lhr-solar/BPS-DisplayPCB/bps_display.FCStd

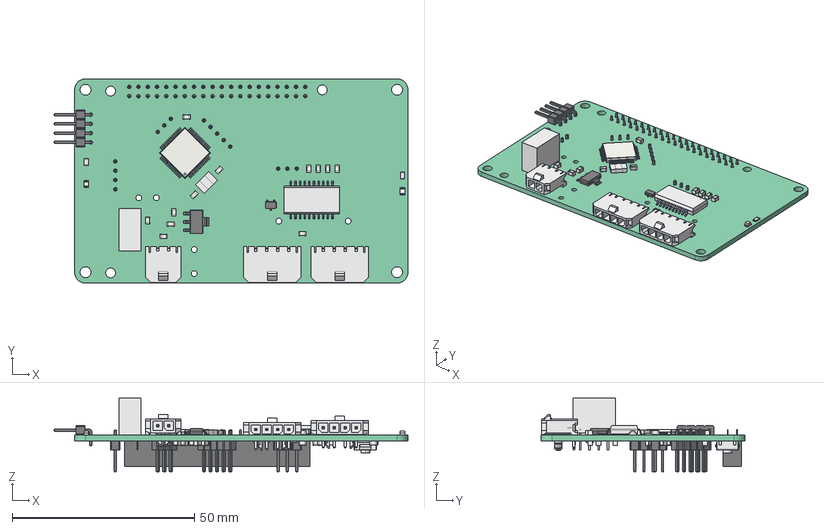
[picture p1: CAD file, 2023-05-16]
bps_display.FCStd
97.0 x 56.0 x 20.2 mm
Pcb_20f8
U2_RI_20_1_ADI_5F66359D[2]
U3_SOT_23W_5F8B4F3E
J2_436500400_5FDCC974[2]
R4_R_0805_2012Metric_5FDE32D0
D2_LED_0805_2012Metric_5FDCB850
J3_436500400_5F821408[2]
U7_SOT_223_5F8224BE
R7_R_0805_2012Metric_5F5D4CE2
D1_LED_0805_2012Metric_5F5D4B01
C25_C_0805_2012Metric_5F5D4AEE
C24_C_0805_2012Metric_5FDE2ECA
C23_C_0805_2012Metric_5FDE28B4
C22_C_0805_2012Metric_5F664578
C19_C_0805_2012Metric_5F5D4AAA
C18_C_0805_2012Metric_5F8B46F2
C17_C_0805_2012Metric_5F5D4A88
C16_C_0805_2012Metric_5FDE1973
C14_C_0805_2012Metric_5FDE4908
Y1_CRYSTAL_TXC_7A_TXC_5F5D3D47[2]
U1_LQFP_64_10x10mm_P05mm_5FDE7541
J1_PinHeader_1x04_P254mm_Horizontal_5F5D6779
C11_C_0805_2012Metric_5F5D3C04
C10_C_0805_2012Metric_5F5D3BF3
C9_C_0805_2012Metric_5F5D6A39
J5_436500200_5F8B5146[2]
U6_CUI_PDS1-S12-S5-S_5FDE26E9
R2_R_0805_2012Metric_5F8B4C7D
J6_PinHeader_1x03_P254mm_Vertical_5F8B5AE3
P1_PinSocket_2x20_P254mm_Vertical_5F8B462C
J9_PinHeader_1x03_P254mm_Vertical_5F8B6365
J8_PinHeader_1x04_P254mm_Vertical_5FDE31D0
J7_PinHeader_1x05_P254mm_Vertical_5F8B6C4F
R3_R_0805_2012Metric_5F8B4C1D
R1_R_0805_2012Metric_5F66A47C
L2_L_0805_2012Metric_5F8B4C4D
L1_L_0805_2012Metric_5F8B4CF5
C15_C_0805_2012Metric_5FDE48B7
C13_C_0805_2012Metric_5F8B4BED
C12_C_0805_2012Metric_5F8B4B5D
SW1_B3SL_100[]P_5F5D3CCB[2]
C8_C_0805_2012Metric_5F5D3BD1
C7_C_0805_2012Metric_5F8B425E
C6_C_0805_2012Metric_5F5D3BAF
C5_C_0805_2012Metric_5FDE7AA1
C4_C_0805_2012Metric_5F5D3B8D
C3_C_0805_2012Metric_5F5D3B7C
C2_C_0805_2012Metric_5F8BED01
C1_C_0805_2012Metric_5F5D3B5A
