lhr-solar/BPS-DisplayPCB/BPSDisplay.kicad_pcb

## KiCad design BPSDisplay.kicad_pcb (2023-05-16)

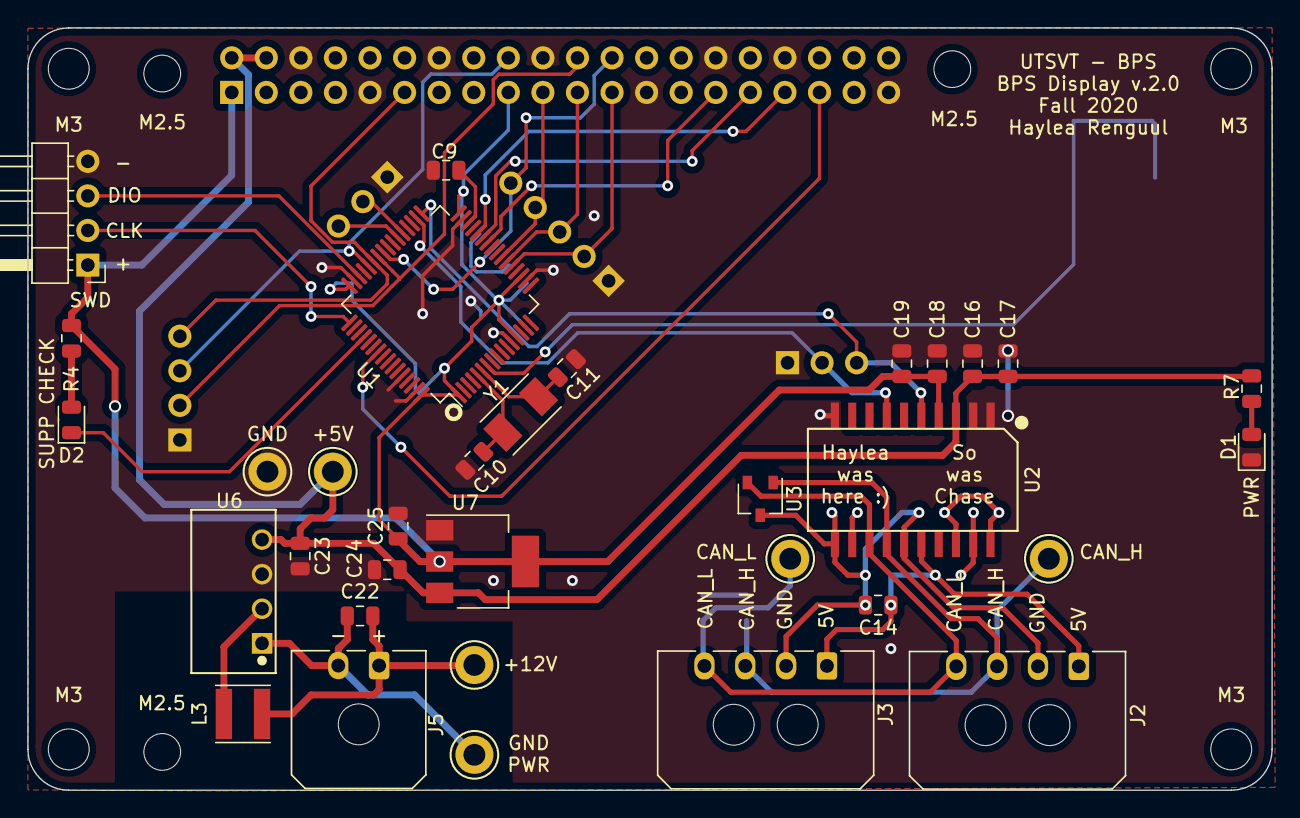
[picture p2: board BPSDisplay.kicad_pcb from above]

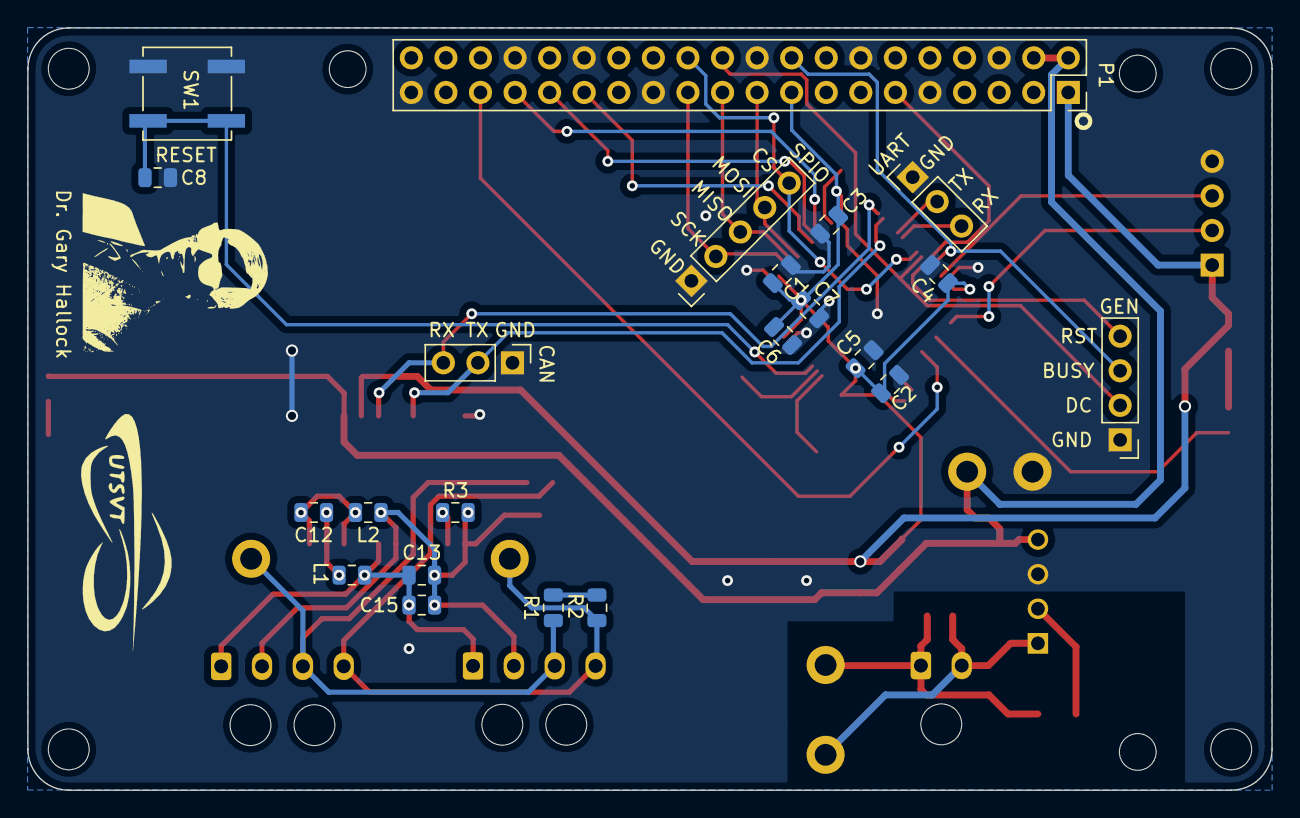
[picture p3: board BPSDisplay.kicad_pcb from below]

Board: 2 copper layers, 91.4 x 56.0 mm, 64 parts (24 on the bottom side), 38 nets.

Parts:
C1, C2, C3, C4, C6, C8: 0.1u; C_0805_2012Metric
C5, C22, C23: 4.7u; C_0805_2012Metric
C7: 1u; C_0805_2012Metric
C9: 2.2u; C_0805_2012Metric
C10, C11: 8p; C_0805_2012Metric
C12: 0.22uF; C_0805_2012Metric
C13, C16: 10uF; C_0805_2012Metric
C14, C17, C18: 0.1uF; C_0805_2012Metric
C15, C19: 0.01uF; C_0805_2012Metric
C24, C25: 10u; C_0805_2012Metric
D1, D2: PowerOn; LED_0805_2012Metric
J1: SWD; PinHeader_1x04_P2.54mm_Horizontal
J2, J3: CAN_Out; Molex_Micro-Fit_3.0_43650-0400_1x04_P3.00mm_Horizontal
J5: CarPowerConnector; Molex_Micro-Fit_3.0_43650-0200_1x02_P3.00mm_Horizontal
J6: CAN_LogicAnalyzer; PinHeader_1x03_P2.54mm_Vertical
J7: SPI0_LogicAnalyzer; PinHeader_1x05_P2.54mm_Vertical
J8: GEN_LogicAnalyzer; PinHeader_1x04_P2.54mm_Vertical
J9: USART_LogicAnalyzer; PinHeader_1x03_P2.54mm_Vertical
L1, L2: 2kH; L_0805_2012Metric
L3: 6.8u; L_Taiyo-Yuden_MD-4040
LOGO1: UTSVT; UTSVT_Logo_Symbol
LOGO2: Dr. Hallock; Hallock_Image_Tiny
MK1, MK2, MK4: M2.5; MountingHole_2.7mm_M2.5
MK3, MK5, MK6, MK7: M3; MountingHole_3mm
P1: Conn_02x20_Odd_Even; PinSocket_2x20_P2.54mm_Vertical
R1, R2: 60; R_0805_2012Metric
R3: 0; R_0805_2012Metric
R4: 750; R_0805_2012Metric
R7: 1.5k; R_0805_2012Metric
SW1: Reset; SW_SPST_B3SL-1002P
TP1: CAN_H; TestPoint_Keystone_5005-5009_Compact
TP2: CAN_L; TestPoint_Keystone_5005-5009_Compact
TP3: +3.3V_TP; TestPoint_Keystone_5005-5009_Compact
TP4: +12V_TP; TestPoint_Keystone_5005-5009_Compact
TP5: GNDPWR_TP; TestPoint_Keystone_5005-5009_Compact
TP6: GND_TP; TestPoint_Keystone_5005-5009_Compact
U1: STM32F413RHTx; LQFP-64_10x10mm_P0.5mm
U2: ADM3055E; SOIC-20W_7.5x15.4mm_Pitch1.27mm
U3: CDSOT23-T24CAN; SOT-23W
U6: PDS1-S12-S5; PDSx-S
U7: NCP1117-3.3_SOT223; SOT-223-3_TabPin2
Y1: 8M; Crystal_SMD_TXC_7A-2Pin_5x3.2mm

Connections:
+3V3: C1.1, C2.1, C3.1, C4.1, C5.1, C6.1, C7.1, C18.1, C19.1, C25.1, J1.1, P1.1, P1.17, R4.1, U1.1, U1.13, U1.19, U1.32, U1.48, U1.64, U2.4, U7.2
+5V: C16.1, C17.1, C23.1, C24.1, P1.2, P1.4, R7.1, TP3.1, U2.3, U6.4, U7.3
+12V: C22.1, J5.1, L3.1, TP4.1
/CAN2_RX: J6.3, U1.33, U2.5
/CAN2_TX: J6.2, U1.34, U2.7
/CAN/CAN_H: J2.3, J3.3, R1.2, TP1.1, U2.14, U3.1
/CAN/CAN_L: J2.4, J3.4, R2.2, TP2.1, U2.13, U3.2
/CAN/RSlope: R3.1, U2.12
/GPIO5: P1.29, U1.26
/GPIO6: P1.31, U1.27
/GPIO8(SPI0_CE_N): J7.5, P1.24, U1.41
/GPIO9(SPI0_MISO): J7.3, P1.21, U1.22
/GPIO10(SPI0_MOSI): J7.4, P1.19, U1.23
/GPIO11(SPI0_SCK): J7.2, P1.23, U1.21
/GPIO13: P1.33, U1.28
/GPIO17(GEN0): J8.4, P1.11, U1.43
/GPIO19: P1.35, U1.55
/GPIO24(GEN5): J8.3, P1.18, U1.44
/GPIO25(GEN6): J8.2, P1.22, U1.42
/NRST: C8.1, SW1.1, U1.7
/SWCLK: J1.2, U1.49
/SWDIO: J1.3, U1.46
/USART6_RX: J9.3, U1.38
/USART6_TX: J9.2, U1.37
GND: C1.2, C2.2, C3.2, C4.2, C5.2, C6.2, C7.2, C8.2, C9.2, C10.2, C11.2, C16.2, C17.2, C18.2, C19.2, C23.2, C24.2, C25.2, D1.1, J1.4, J6.1, J7.1, J8.1, J9.1, P1.6, P1.9, P1.14, P1.20, P1.25, P1.30, P1.34, P1.39, SW1.2, TP6.1, U1.12, U1.18, U1.31, U1.47, U1.60, U1.63, U2.1, U2.2, U2.10, U6.3, U7.1
GNDPWR: C22.2, J5.2, TP5.1, U6.1
unnamed: C9.1, U1.30
unnamed: C10.1, U1.5, Y1.1
unnamed: C11.1, U1.6, Y1.2
unnamed: C12.1, L1.2, U2.19
unnamed: C12.2, L2.2, U2.18, U2.20
unnamed: C13.1, C14.1, C15.1, J2.1, J3.1, L1.1, U2.16
unnamed: C13.2, C14.2, C15.2, J2.2, J3.2, L2.1, R3.2, U2.11, U2.15, U3.3
unnamed: D1.2, R7.2
unnamed: D2.1, U1.52
unnamed: D2.2, R4.2
unnamed: L3.2, U6.2
unnamed: R1.1, R2.1
