lhr-solar/BPS-DisplayPCB/(commit log)

2020-08-02 Set up for own repository
    [BOM.csv, BPS-Nucleo.kicad_pcb, BPS-Nucleo.sch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]
2020-09-12 Deleted hierarchical sheets
    Deleted the hierarchical sheets that were at the bottom left of the schematic (CAN, isoSPI, and Power Distribution) and deleted the connections to them (CAN2_TX, CAN2_RX, SPI3_SCK, SPI3_MISO, SPI3_MOSI, DISPCS). Added no connection flags to the pins that they used to be connected to.
    [BPSDisplay.kicad_pcb]
2020-09-12 Deleted the isoSPI sheet and connections
    On the schematic, I deleted the isoSPI sheet and its connections to the STM (replaced them with no connection flags). I updated the PCB from that so it now has all the components that need to be arranged and it can be done from scratch. I also added in a ground plane.
    [BPSDisplay.sch]
2020-09-13 Updated CAN sheet
    Fixed the CAN interface schematic so it follows the recommended layout. The footprint for the ADM is from the BPS-Master-rescue.lib file so I'm uploading that as well.
2020-09-19 Reattached Lib to project for correct symbol model
    [BPSDisplay.sch]
2020-09-19 Confimred Schematic and generated Netlist
    [BPSDisplay.sch, CAN.sch]
2020-09-19 Rearranging PCB layout
    Power distribution circuit is laid out, CAN interface is done using the recommended PCB layout, and all the mounting holes and connectors are in the same places as they were in the old board.
    [BPSDisplay.kicad_pcb]
2020-09-19 Added traces
    We added some preliminary traces to the PCB. There are a few pins that are still unconnected.
    [BPSDisplay.kicad_pcb]
2020-09-26 Completed Traces and resized to correct dim.
    [BPSDisplay.kicad_pcb]
2020-09-26 Added Labels
    [BPSDisplay.kicad_pcb]
2020-10-03 Edits to PCB layout
    Rounded out corners of the board, added pin labels to connectors, rearranged trace that was too close to U1
    [BPSDisplay.kicad_pcb]
2020-10-03 Making left edge cut straight
    [BPSDisplay.kicad_pcb]
2020-10-03 Editing PCB layout
    Moved mounting holes into the correct order/spots, moved U6 closer to the left edge of the board (since it's a taller component), removed the sharp angle near C17
    [BPSDisplay.kicad_pcb]
2020-10-03 Removed traces under Y1
    Also aligned J5 with U6
    [BPSDisplay.kicad_pcb]
2020-10-10 Split Logic Analyzer
    & added second CAN connector
    [BPSDisplay.sch]
2020-10-10 Added footprints to connectors
    Made all connector footprints horizontal too
    [BPSDisplay.sch]
2020-10-10 New PCB layout
    Split logic analyzer into different connector pins, added labels, moved all connectors to south side of the board
    [BPSDisplay.kicad_pcb]
2020-10-10 Added circle to indicate pin 1 of U2
    [BPSDisplay.kicad_pcb]
2020-10-17 Updated footprints, re-routed traces
    Changed logical analyzer footprints to vertical, changed 2x20 connector footprint back to the original footprint, changed CAN headers to vertical footprints.
    Grouped components better so logic analyzer pins are closer to their corresponding pins on the microcontroller. Re-did traces accordingly.
    [BPSDisplay.kicad_pcb, BPSDisplay.sch]
2020-10-17 Updated footprints, re-routed traces
2020-10-17 Fixed traces
    Got rid of traces with right angles, made labels on CAN headers vertical, made traces neater, added logo and picture of Dr. Hallock on back
    [BPSDisplay.kicad_pcb, BPSDisplay.sch]
2020-10-24 Aligning components, editing text
    Aligned connectors on the south end to the edge of the board, edited text for title of the board, rotated JP1 90 degrees clockwise, and removed the trace appendage on C5.
    [BPSDisplay.kicad_pcb]
2020-11-07 Fixed labels
    [BPSDisplay.kicad_pcb]
2020-11-07 Moved traces to avoid shorts
    [BPSDisplay.kicad_pcb]
2020-12-18 Adds LED for supplementals, deletes unncessary files, and links all symbols to the submodule
    [BPSDisplay.kicad_pcb, BPSDisplay.sch, CAN.sch, PowerDist.sch]
2020-12-19 Redo most of the layout to fix issues.
    [BPSDisplay.kicad_pcb, BPSDisplay.sch, CAN.sch, PowerDist.sch]
2020-12-19 Adds another mounting hole, moves PWR LED, and adds labels to test points
    [BPSDisplay.kicad_pcb, BPSDisplay.sch]
2021-01-23 3-D Models
    Adds 3-D models for switch, crystal, connectors, and chips. Adds FreeCAD file for the PCB.
    [BPSDisplay.kicad_pcb, bps_display.FCStd]
